CITROMOSEPER/7-DSG-transmission-control-unit/Képek/Műszerfal.JPEG

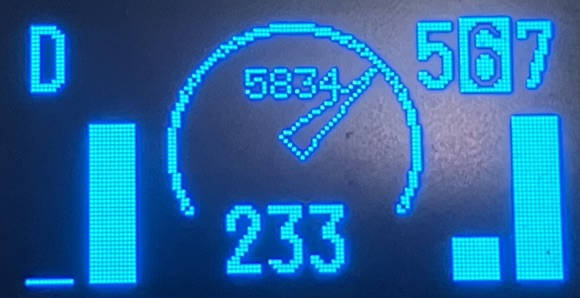
Képek/Műszerfal.JPEG
