CITROMOSEPER/7-DSG-transmission-control-unit/Képek/IMG_2523.JPEG

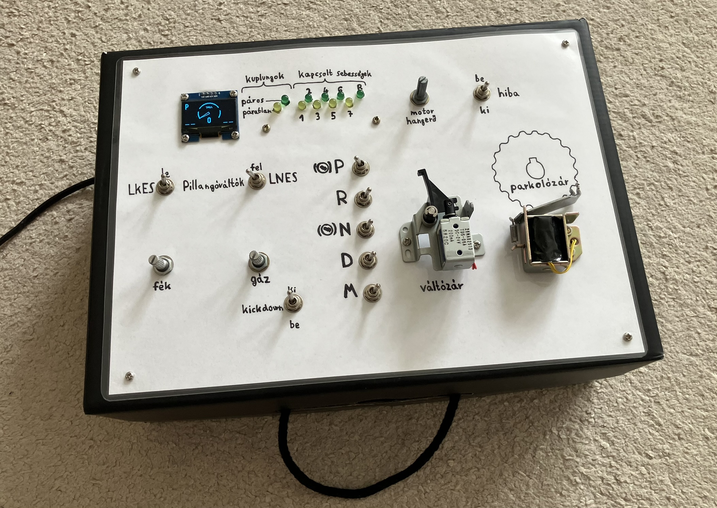
Képek/IMG_2523.JPEG
