CITROMOSEPER/7-DSG-transmission-control-unit/7DSG support circuit/7DSG support circuit.kicad_sch

## KiCad design 7DSG support circuit/7DSG support circuit.kicad_sch (2026-09-27)

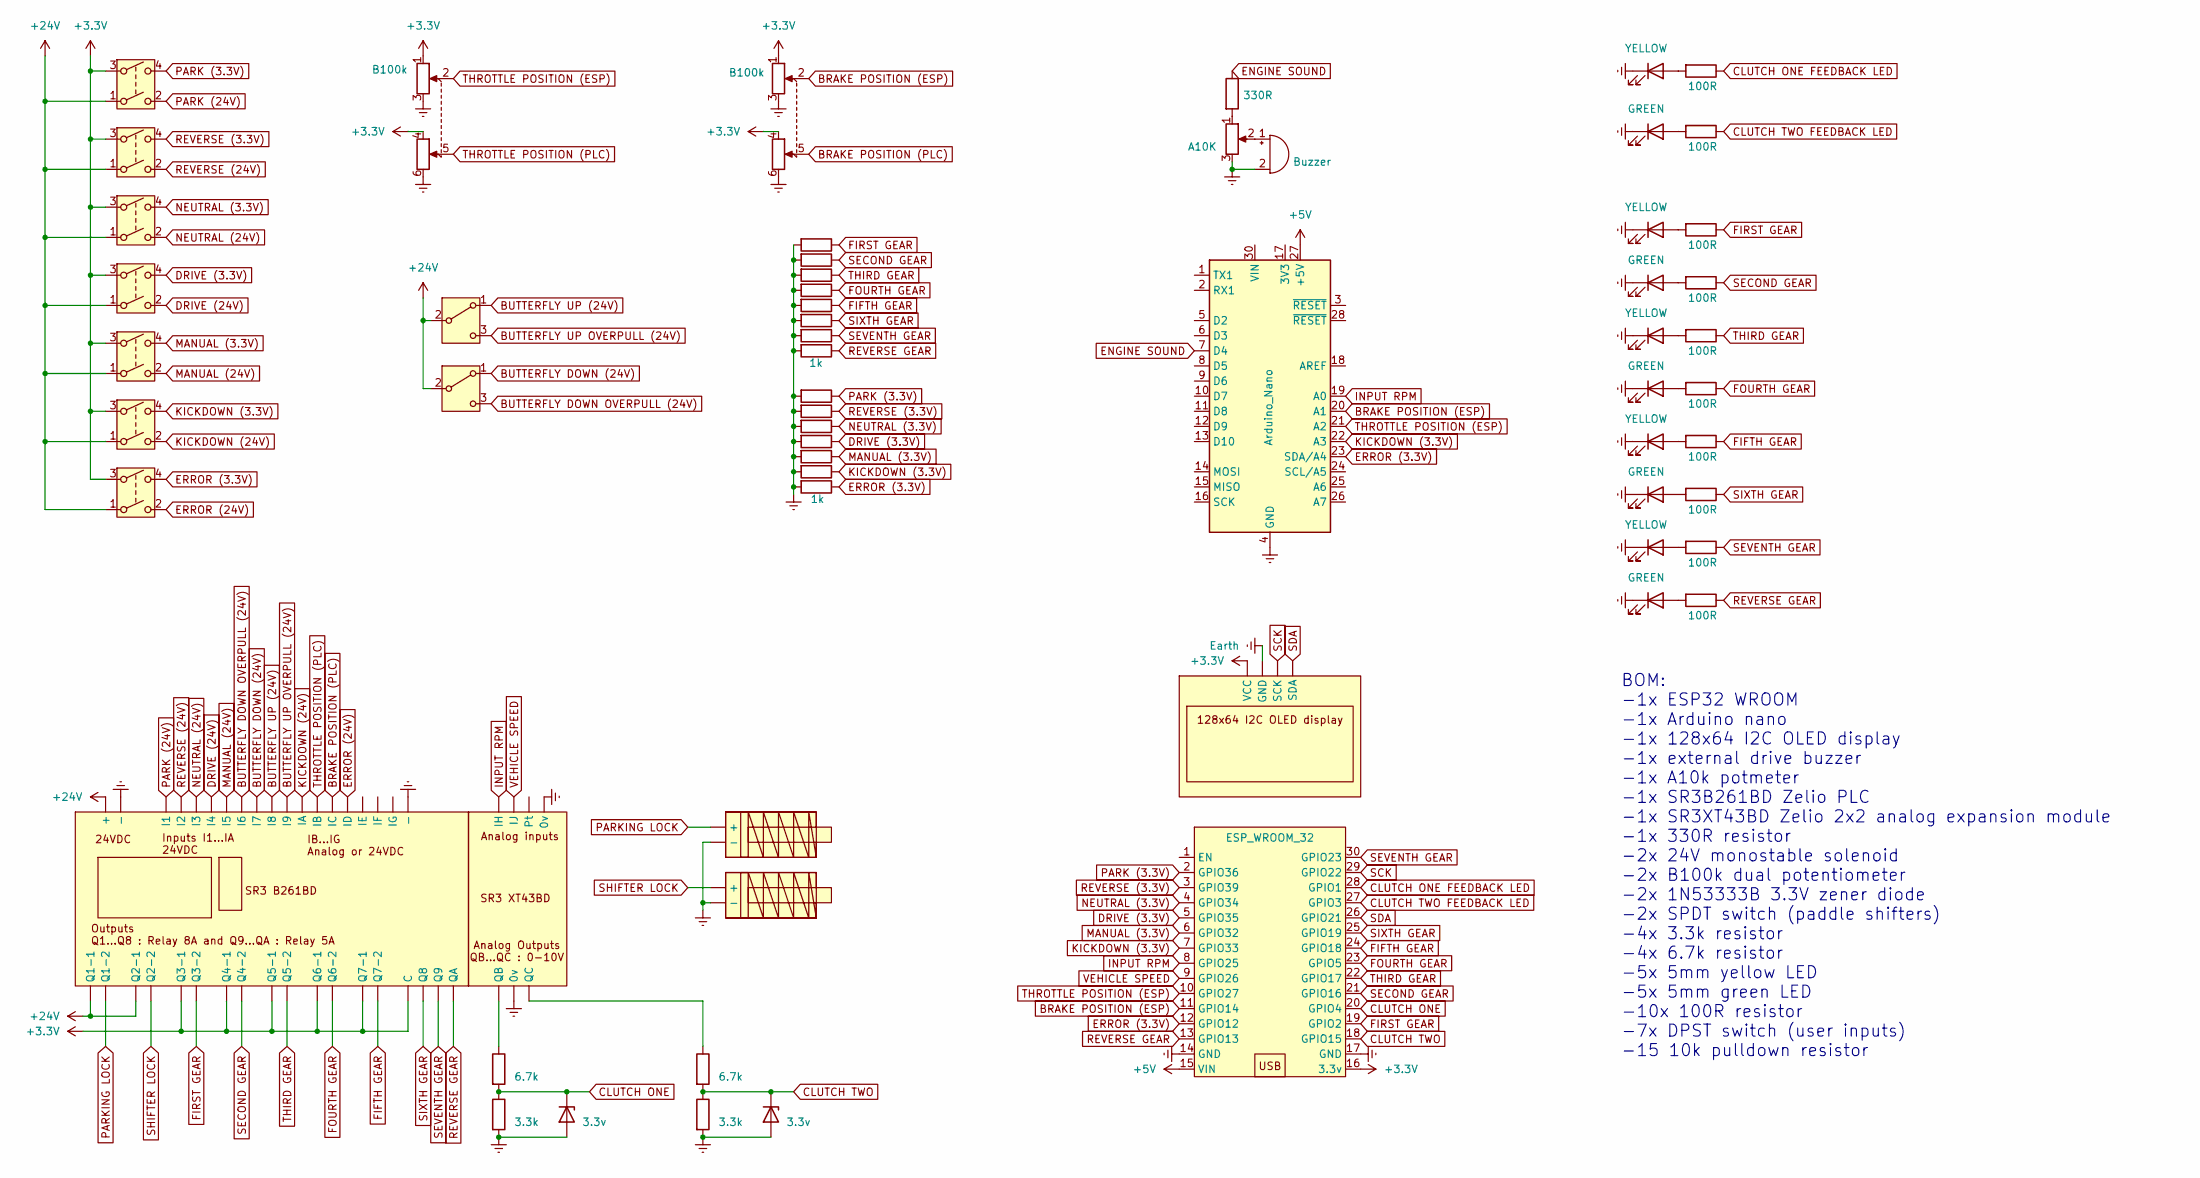
[picture p28: schematic 7DSG support circuit.kicad_sch]

Parts:
A1: Arduino_Nano
BZ1: Buzzer
D1, D2: 3.3v
D3, D6, D7, D9, D11: YELLOW
D4, D5, D8, D10, D12: GREEN
ESP_WROOM_32: (no value)
R1, R3: 6.7k
R2, R4: 3.3k
R5, R6, R7, R8, R9, R10, R11, R12, R17, R19, R21, R24, R25, R27, R29: 1k
R39, R40, R49, R50, R51, R52, R53, R54, R55, R56: 100R
R41: 330R
RV3: A10K
RV4, RV5: B100k
SW1, SW2, SW3, SW4, SW5, SW6, SW12: SW_DPST
SW7, SW8: SW_SPDT
U1, U2, U3, U4, U5: (no value)

Connections:
+3.3V: ESP_WROOM_32.16 (3.3v), RV4.1, RV4.4, RV5.1, RV5.4, SW1.3, SW2.3, SW3.3, SW4.3, SW5.3, SW6.3, SW12.3, U1., U3.
+5V: A1.27 (+5V), ESP_WROOM_32.15 (VIN)
+24V: SW1.1, SW2.1, SW3.1, SW4.1, SW5.1, SW6.1, SW7.2 (B), SW8.2 (B), SW12.1, U1.
BRAKE POSITION (ESP): A1.20 (A1), ESP_WROOM_32.11 (GPIO14), RV5.2
BRAKE POSITION (PLC): RV5.5, U1.
BUTTERFLY DOWN (24V): SW7.1 (A), U1.
BUTTERFLY DOWN OVERPULL (24V): SW7.3 (C), U1.
BUTTERFLY UP (24V): SW8.1 (A), U1.
BUTTERFLY UP OVERPULL (24V): SW8.3 (C), U1.
CLUTCH ONE: D1.1 (K), ESP_WROOM_32.20 (GPIO4), R1.2, R2.1
CLUTCH ONE FEEDBACK LED: ESP_WROOM_32.28 (GPIO1), R39.1
CLUTCH TWO: D2.1 (K), ESP_WROOM_32.18 (GPIO15), R3.2, R4.1
CLUTCH TWO FEEDBACK LED: ESP_WROOM_32.27 (GPIO3), R40.1
DRIVE (3.3V): ESP_WROOM_32.5 (GPIO35), R17.1, SW3.4
DRIVE (24V): SW3.2, U1.
ENGINE SOUND: A1.7 (D4), R41.1
ERROR (3.3V): A1.23 (SDA/A4), ESP_WROOM_32.12 (GPIO12), R24.1, SW6.4
ERROR (24V): SW6.2, U1.
Earth: A1.4 (GND), A1.29 (GND), BZ1.2 (-), D1.2 (A), D2.2 (A), D3.1 (K), D4.1 (K), D5.1 (K), D6.1 (K), D7.1 (K), D8.1 (K), D9.1 (K), D10.1 (K), D11.1 (K), D12.1 (K), ESP_WROOM_32.14 (GND), ESP_WROOM_32.17 (GND), R2.2, R4.2, R5.2, R6.2, R7.2, R8.2, R9.2, R10.2, R11.2, R12.2, R17.2, R19.2, R21.2, R24.2, R25.2, R27.2, R29.2, RV3.3, RV4.3, RV4.6, RV5.3, RV5.6, U1., U2., U3., U4., U5.
FIFTH GEAR: ESP_WROOM_32.24 (GPIO18), R9.1, R50.1, U1.
FIRST GEAR: ESP_WROOM_32.19 (GPIO2), R5.1, R55.1, U1.
FOURTH GEAR: ESP_WROOM_32.23 (GPIO5), R8.1, R54.1, U1.
INPUT RPM: A1.19 (A0), ESP_WROOM_32.8 (GPIO25), U2.
KICKDOWN (3.3V): A1.22 (A3), ESP_WROOM_32.7 (GPIO33), R21.1, SW5.4
KICKDOWN (24V): SW5.2, U1.
MANUAL (3.3V): ESP_WROOM_32.6 (GPIO32), R19.1, SW4.4
MANUAL (24V): SW4.2, U1.
NEUTRAL (3.3V): ESP_WROOM_32.4 (GPIO34), R29.1, SW2.4
NEUTRAL (24V): SW2.2, U1.
unnamed: BZ1.1 (+), RV3.2
unnamed: D3.2 (A), R39.2
unnamed: D4.2 (A), R40.2
unnamed: D5.2 (A), R49.2
unnamed: D6.2 (A), R50.2
unnamed: D7.2 (A), R51.2
unnamed: D8.2 (A), R52.2
unnamed: D9.2 (A), R53.2
unnamed: D10.2 (A), R54.2
unnamed: D11.2 (A), R55.2
unnamed: D12.2 (A), R56.2
unnamed: R1.1, U2.
unnamed: R3.1, U2.
unnamed: R41.2, RV3.1
PARK (3.3V): ESP_WROOM_32.2 (GPIO36), R25.1, SW12.4
PARK (24V): SW12.2, U1.
PARKING LOCK: U1., U4.
REVERSE (3.3V): ESP_WROOM_32.3 (GPIO39), R27.1, SW1.4
REVERSE (24V): SW1.2, U1.
REVERSE GEAR: ESP_WROOM_32.13 (GPIO13), R12.1, R52.1, U1.
SCK: ESP_WROOM_32.29 (GPIO22), U3.
SDA: ESP_WROOM_32.26 (GPIO21), U3.
SECOND GEAR: ESP_WROOM_32.21 (GPIO16), R6.1, R56.1, U1.
SEVENTH GEAR: ESP_WROOM_32.30 (GPIO23), R11.1, R51.1, U1.
SHIFTER LOCK: U1., U5.
SIXTH GEAR: ESP_WROOM_32.25 (GPIO19), R10.1, R49.1, U1.
THIRD GEAR: ESP_WROOM_32.22 (GPIO17), R7.1, R53.1, U1.
THROTTLE POSITION (ESP): A1.21 (A2), ESP_WROOM_32.10 (GPIO27), RV4.2
THROTTLE POSITION (PLC): RV4.5, U1.
VEHICLE SPEED: ESP_WROOM_32.9 (GPIO26), U2.

Notes on the sheet:
BOM: -1x ESP32 WROOM -1x Arduino nano -1x 128x64 I2C OLED display -1x external drive buzzer -1x A10k potmeter -1x SR3B261BD Zelio PLC -1x SR3XT43BD Zelio 2x2 analog expansion module -1x 330R resistor -2x 24V monostable solenoid -2x B100k dual potentiometer -2x 1N53333B 3.3V zener diode -2x SPDT swi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
