CITROMOSEPER/7-DSG-transmission-control-unit/7DSG_support/PINS.h

#define P_LEVER 36 // digital input
#define R_LEVER 39 // digital input
#define N_LEVER 34 // digital input
#define D_LEVER 35 // digital input
#define M_LEVER 32 // digital input

//#define BUTTERFLY_DOWN 
//#define BUTTERFLY_UP 
//#define BUTTERFLY_DOWN_OVERPULL 
//#define BUTTERFLY_UP_OVERPULL

#define KICKDOWN_PIN 33 // digital input

#define THROTTLE_POSITION 27 // analog input
#define BRAKE_POSITION 14 // analog input
#define INPUT_RPM 25 // analog output
#define VEHICLE_SPEED 26 // analog output
#define ERROR_PIN 12 // digital input

#define FIRST_GEAR   2  // digital input
#define SECOND_GEAR  16 // digital input
#define THIRD_GEAR   17 // digital input
#define FOURTH_GEAR  5  // digital input
#define FIFTH_GEAR   18 // digital input
#define SIXTH_GEAR   19 // digital input
#define SEVENTH_GEAR 23 // digital input
#define REVERSE_GEAR 13 // digital input

#define CLUTCH_ONE 4  // analog input
#define CLUTCH_TWO 15 // analog input

#define SDA 21
#define SCK 22

#define CLUTCH_ONE_DISPLAY 1
#define CLUTCH_TWO_DISPLAY 3
