CITROMOSEPER/7-DSG-transmission-control-unit/Engine_sound_generator/PINS.h

#define SOUND_OUTPUT_PIN 2

#define KICKDOWN_INPUT_PIN A4
#define RPM_INPUT_PIN A3
#define THROTTLE_INPUT_PIN A2
#define BRAKE_INPUT_PIN A1
#define ERROR_INPUT_PIN A0
